kacperjurak/dtk-386-replica/images/umc_back_flip.jpg

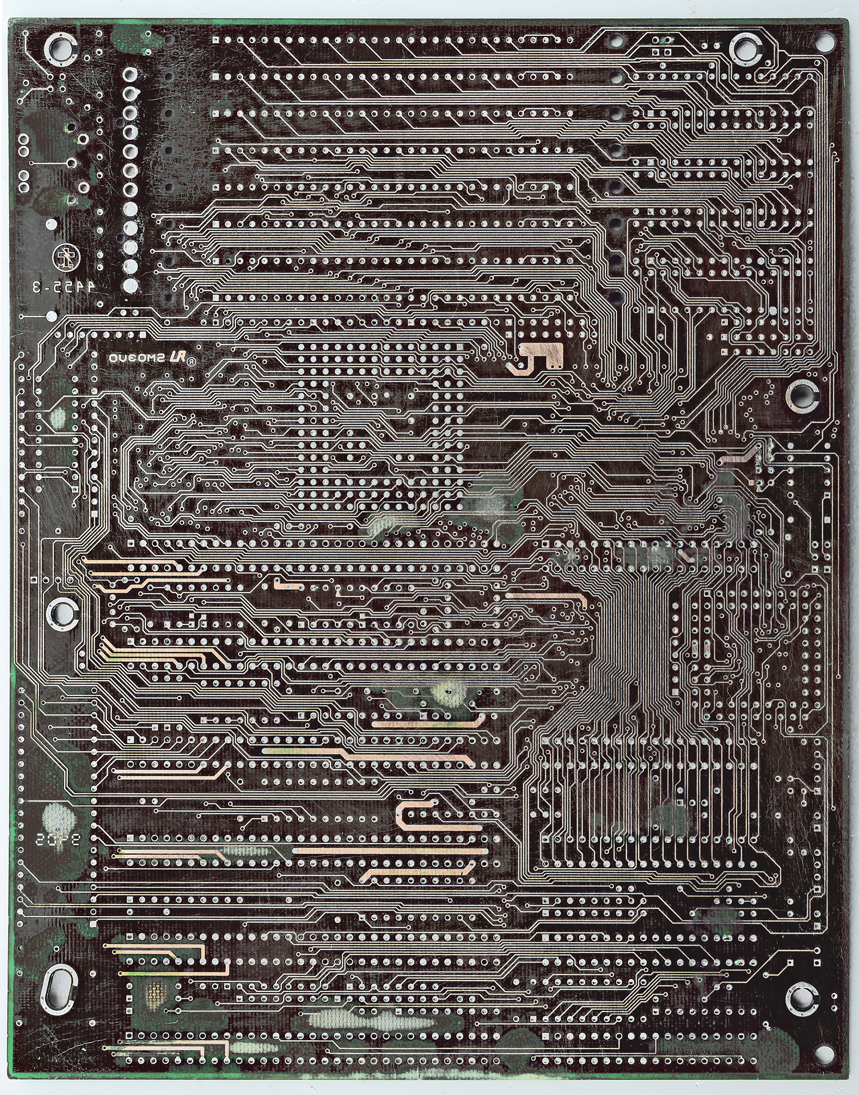
images/umc_back_flip.jpg
