kacperjurak/dtk-386-replica/images/umc_front.jpg

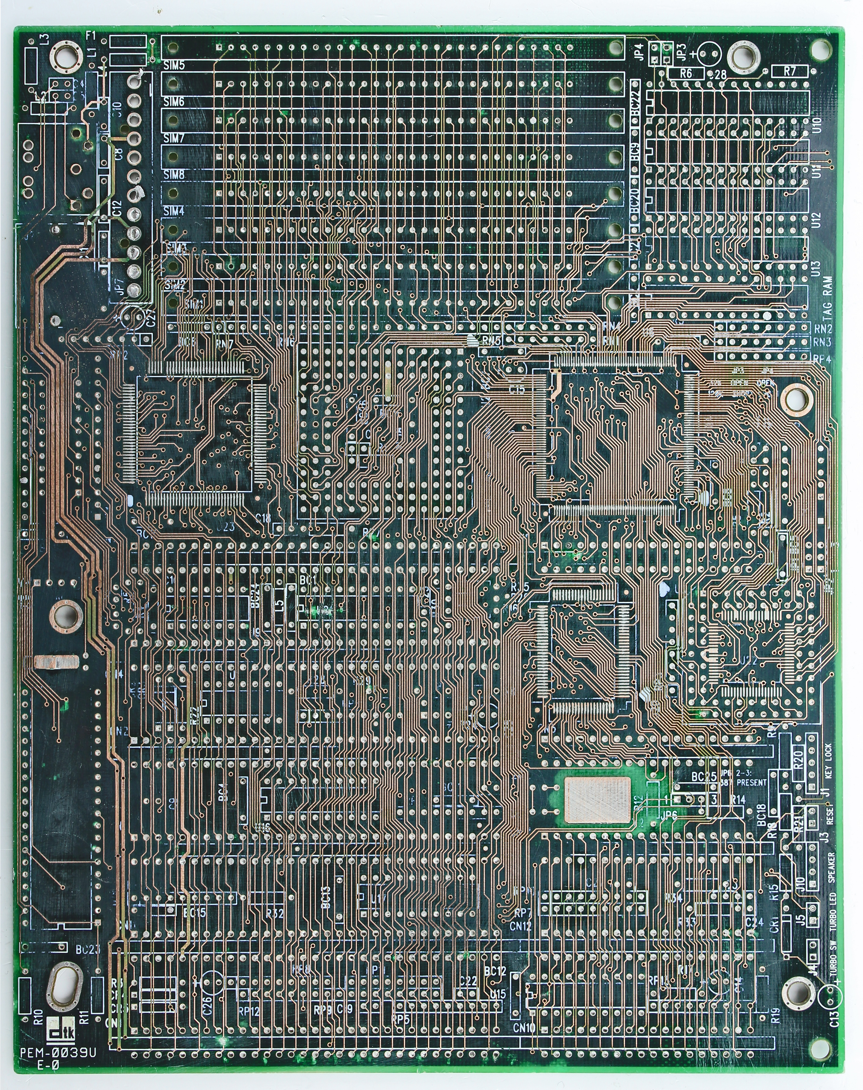
images/umc_front.jpg
