kacperjurak/dtk-386-replica/kicad/UMC-AT.kicad_pcb

## KiCad design kicad/UMC-AT.kicad_pcb (2026-10-24)

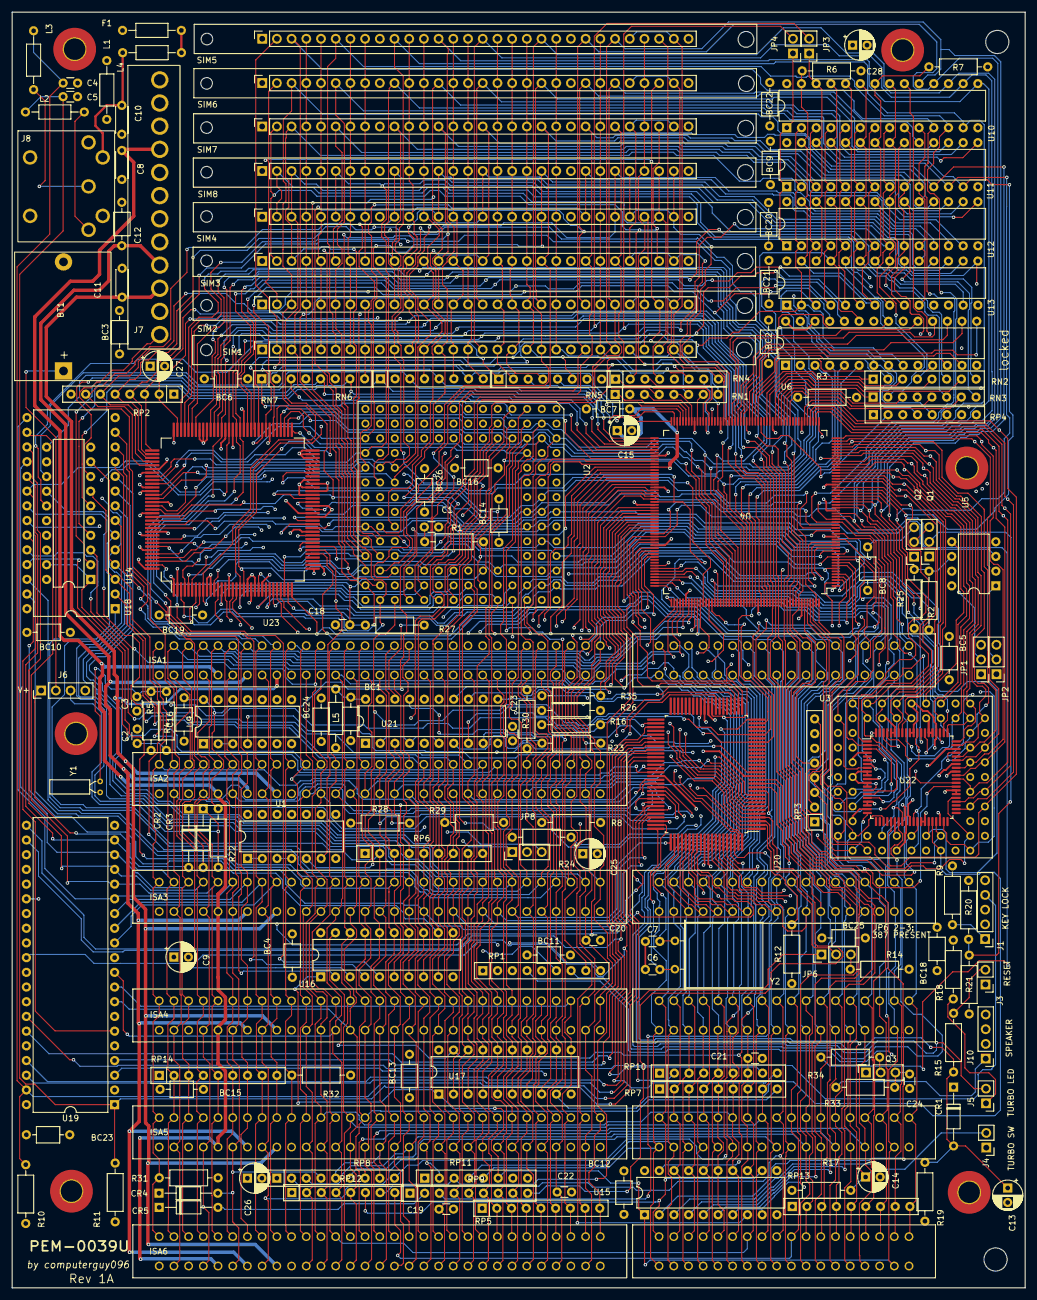
[picture p4: board UMC-AT.kicad_pcb from above]

Board: 4 copper layers, 175.0 x 220.4 mm, 179 parts (0 on the bottom side), 337 nets.

Parts:
BC1, BC2, BC3, BC4, BC5, BC6, BC7, BC8, BC9, BC10, BC11, BC12, BC13, BC14, BC15, BC16, BC18, BC19, BC20, BC21, BC22, BC23, BC24, BC25, BC26: 100nF; C_Axial_L3.8mm_D2.6mm_P7.50mm_Horizontal
BT1: 3.6V NiCd; BATT
C1, C2, C3, C4, C5, C18, C19, C20, C21, C22, C23, C24: C; C_Disc_D3.0mm_W1.6mm_P2.50mm
C6, C7: 10pF; C_Disc_D3.0mm_W1.6mm_P2.50mm
C8, C10, C11: C; C_Disc_D4.3mm_W1.9mm_P5.00mm
C9, C13, C14, C15, C25, C26, C27, C28: 10uF; CP_Radial_D5.0mm_P2.50mm
C12, C16: C; C_Axial_L3.8mm_D2.6mm_P7.50mm_Horizontal
CR1, CR2, CR3, CR4, CR5: 1N4148; D_DO-35_SOD27_P10.16mm_Horizontal
F1: 1A; L_Axial_L5.3mm_D2.2mm_P10.16mm_Horizontal_Vishay_IM-1
H1, H2, H3, H4, H5, H6: MountingHole_Pad; MountingHole_3.7mm_Pad_TopBottom
ISA1, ISA3, ISA4, ISA5, ISA6: Bus_ISA_16bit; ISA16
ISA2: Bus_ISA_8bit; ISA8
J1: KEY LOCK; PinHeader_1x05_P2.54mm_Vertical
J3: RESET; PinHeader_1x02_P2.54mm_Vertical
J4: TURBO SW; PinHeader_1x02_P2.54mm_Vertical
J5: TURBO LED; PinHeader_1x02_P2.54mm_Vertical
J6: V+; PinHeader_1x04_P2.54mm_Vertical
J7: ATPWR
J8: KB_DIN5
J10: SPEAKER; PinHeader_1x04_P2.54mm_Vertical
JP1, JP2, JP8: PinHeader_1x03_P2.54mm_Vertical
JP3, JP4: PinHeader_1x02_P2.54mm_Vertical
JP6: 387 PRESENT; PinHeader_1x03_P2.54mm_Vertical
L1, L2, L3, L4, L5: FerriteBead; L_Axial_L5.3mm_D2.2mm_P10.16mm_Horizontal_Vishay_IM-1
Q1, Q3: 2N3904; PinSocket_1x03_P2.54mm_Vertical
Q2: 2N3906; PinSocket_1x03_P2.54mm_Vertical
R1, R2, R4, R5, R6, R7, R8, R9, R10, R11, R12, R14, R15, R16, R17, R18, R19, R20, R21, R22, R23, R24, R25, R26, R28, R29, R30, R31, R32, R33, R34, R35: R; R_Axial_DIN0207_L6.3mm_D2.5mm_P10.16mm_Horizontal
R3: 10R; R_Axial_DIN0207_L6.3mm_D2.5mm_P10.16mm_Horizontal
R27: 33R; R_Axial_DIN0207_L6.3mm_D2.5mm_P10.16mm_Horizontal
RN1, RN2, RN3, RN4, RN5, RN6, RN7: 33R; R_Array_SIP8
RP1, RP5, RP6, RP7, RP8, RP9, RP10, RP13, RP14: 4.7K; R_Array_SIP9
RP2, RP3, RP4, RP11, RP12: 4.7K; R_Array_SIP8
SIM1, SIM2, SIM3, SIM4, SIM5, SIM6, SIM7, SIM8: PinSocket_1x30_P2.54mm_Vertical
U1: 74LS00; DIP-14_W7.62mm
U2: 80386; PGA-132
U3: 80387; PGA-68
U4: 82C491; QFP-208
U5: AV9107; DIP-8_W7.62mm
U6, U10, U11, U12, U13: CY62256-70PC; DIP-28_W7.62mm
U9: 4069; DIP-14_W7.62mm
U14, U21: 74LS244; DIP-20_W7.62mm
U15, U16, U17: 74LS245; DIP-20_W7.62mm
U18: 27C512; DIP-28_W15.24mm
U19: DIP-40_W15.24mm
U20: 82C493; QFP-100
U22: Cx87DLC; LQFP-80_14x14mm_P0.65mm
U23: Am386DX; QFP-132
Y1: 32.768KHz; Crystal_C26-LF_D2.1mm_L6.5mm_Horizontal
Y2: 14.318MHz; Crystal_HC49-U_Horizontal

Connections:
+12V: C11.1, ISA1.9 (+12V), ISA2.9 (+12V), ISA3.9 (+12V), ISA4.9 (+12V), ISA5.9 (+12V), ISA6.9 (+12V), J7.10 (+12V)
-5V: C8.2, ISA1.5 (-5V), ISA2.5 (-5V), ISA3.5 (-5V), ISA4.5 (-5V), ISA5.5 (-5V), ISA6.5 (-5V), J7.4 (-5V)
-12V: C12.1, ISA1.7 (-12V), ISA2.7 (-12V), ISA3.7 (-12V), ISA4.7 (-12V), ISA5.7 (-12V), ISA6.7 (-12V), J7.9 (-12V)
/CPU/PULLUP: RP1.7 (R6), U22.27 (PULLUP)
/CPU/READYO: RP3.3 (R2), U3.L3 (~READYO)
/Cache and TAG/AA10: RN2.4 (R2.2), U10.21 (A10), U11.21 (A10), U12.21 (A10), U13.21 (A10)
/Cache and TAG/AA11: RN2.6 (R3.2), U10.23 (A11), U11.23 (A11), U12.23 (A11), U13.23 (A11)
/Cache and TAG/AA13: JP3.1, RP4.5 (R4), U6.8 (A2), U10.26 (A13), U11.26 (A13), U12.26 (A13), U13.26 (A13)
/Cache and TAG/AA14: JP4.1, RP4.4 (R3), U6.7 (A3), U10.1 (A14), U11.1 (A14), U12.1 (A14), U13.1 (A14)
/Cache and TAG/CA2: RN2.3 (R2.1), U4.71 (CA2)
/Cache and TAG/CA3A: RN2.5 (R3.1), U4.70 (CA3A)
/Cache and TAG/COEA: RN2.7 (R4.1), U4.68 (~COEA)
/Cache and TAG/CS0: RN3.4 (R2.2), U10.20 (~CS)
/Cache and TAG/CS1: RN3.6 (R3.2), U11.20 (~CS)
/Cache and TAG/CS2: RN3.8 (R4.2), U12.20 (~CS)
/Cache and TAG/CS3: R3.2, U13.20 (~CS)
/Cache and TAG/CWEA: RN3.1 (R1.1), U4.67 (~CWEA)
/Cache and TAG/OE: R7.1, RN2.8 (R4.2), U10.22 (~OE), U11.22 (~OE), U12.22 (~OE), U13.22 (~OE)
/Cache and TAG/TAG0: U4.83 (TAG0), U6.19 (Q7)
/Cache and TAG/TAG1: U4.82 (TAG1), U6.18 (Q6)
/Cache and TAG/TAG2: U4.81 (TAG2), U6.17 (Q5)
/Cache and TAG/TAG3: U4.80 (TAG3), U6.16 (Q4)
/Cache and TAG/TAG4: U4.79 (TAG4), U6.15 (Q3)
/Cache and TAG/TAG5: U4.77 (TAG5), U6.13 (Q2)
/Cache and TAG/TAG6: U4.76 (TAG6), U6.12 (Q1)
/Cache and TAG/TAG7: U4.75 (TAG7), U6.11 (Q0)
/Cache and TAG/TAGWE: RN2.1 (R1.1), U4.74 (~TAGWE)
/Cache and TAG/TWE: RN2.2 (R1.2), U6.27 (~WE)
/Cache and TAG/WE: R6.1, RN3.2 (R1.2), U10.27 (~WE), U11.27 (~WE), U12.27 (~WE), U13.27 (~WE)
/Chipset/BUFCLK: R28.2, U21.3 (O3b)
/Chipset/CHPCLK: R26.2, U4.141 (ATCLK)
/Chipset/DAC0: U4.116 (DAC0), U20.5 (DAC0)
/Chipset/DAC1: U4.114 (DAC1), U20.6 (DAC1)
/Chipset/DAC2: U4.113 (DAC2), U20.7 (DAC2)
/Chipset/FPUEN: JP6.2, U4.118 (SEL1), U20.3 (SEL1)
/Chipset/JP8/3: JP8.3, U21.16 (O1a)
/Chipset/LOWEN: R35.2, U4.130 (~LOWEN), U20.33 (~LOWEN)
/Chipset/MUXI0: U4.123 (MUXI0), U20.99 (MUXI0)
/Chipset/MUXI1: U4.121 (MUXI1), U20.100 (MUXI1)
/Chipset/MUXI2: U4.120 (MUXI2), U20.1 (MUXI2)
/Chipset/PALE: U4.143 (ALE), U21.11 (I0b)
/Chipset/POWGD: U4.129 (POWGD), U20.34 (POWGD)
/Chipset/RSTIN: U4.171 (~RSTIN), U20.29 (~RSTIN)
/Chipset/SYSCLK: C23.1, R30.1, U20.16 (SYSCLK)
/Chipset/XTL1: C6.2, U20.80 (XTL2), Y2.1
/Chipset/XTL2: C7.2, U20.79 (XTL1), Y2.2
/DRAM/A11: RN4.8 (R4.2), SIM1.24 (A11), SIM2.24 (A11), SIM3.24 (A11), SIM4.24 (A11), SIM5.24 (A11), SIM6.24 (A11), SIM7.24 (A11), SIM8.24 (A11)
/DRAM/CAS0: RN1.4 (R2.2), SIM1.2 (~CAS), SIM1.28 (~CASP), SIM5.2 (~CAS), SIM5.28 (~CASP)
/DRAM/CAS1: RN1.8 (R4.2), SIM2.2 (~CAS), SIM2.28 (~CASP), SIM6.2 (~CAS), SIM6.28 (~CASP)
/DRAM/CAS2: RN4.2 (R1.2), SIM3.2 (~CAS), SIM3.28 (~CASP), SIM7.2 (~CAS), SIM7.28 (~CASP)
/DRAM/CAS3: RN4.4 (R2.2), SIM4.2 (~CAS), SIM4.28 (~CASP), SIM8.2 (~CAS), SIM8.28 (~CASP)
/DRAM/MA0: RN7.2 (R1.2), SIM1.4 (A0), SIM2.4 (A0), SIM3.4 (A0), SIM4.4 (A0), SIM5.4 (A0), SIM6.4 (A0), SIM7.4 (A0), SIM8.4 (A0)
/DRAM/MA1: RN7.4 (R2.2), SIM1.5 (A1), SIM2.5 (A1), SIM3.5 (A1), SIM4.5 (A1), SIM5.5 (A1), SIM6.5 (A1), SIM7.5 (A1), SIM8.5 (A1)
/DRAM/MA2: RN7.6 (R3.2), SIM1.7 (A2), SIM2.7 (A2), SIM3.7 (A2), SIM4.7 (A2), SIM5.7 (A2), SIM6.7 (A2), SIM7.7 (A2), SIM8.7 (A2)
/DRAM/MA3: RN7.8 (R4.2), SIM1.8 (A3), SIM2.8 (A3), SIM3.8 (A3), SIM4.8 (A3), SIM5.8 (A3), SIM6.8 (A3), SIM7.8 (A3), SIM8.8 (A3)
/DRAM/MA4: RN6.2 (R1.2), SIM1.11 (A4), SIM2.11 (A4), SIM3.11 (A4), SIM4.11 (A4), SIM5.11 (A4), SIM6.11 (A4), SIM7.11 (A4), SIM8.11 (A4)
/DRAM/MA5: RN6.4 (R2.2), SIM1.12 (A5), SIM2.12 (A5), SIM3.12 (A5), SIM4.12 (A5), SIM5.12 (A5), SIM6.12 (A5), SIM7.12 (A5), SIM8.12 (A5)
/DRAM/MA6: RN6.6 (R3.2), SIM1.14 (A6), SIM2.14 (A6), SIM3.14 (A6), SIM4.14 (A6), SIM5.14 (A6), SIM6.14 (A6), SIM7.14 (A6), SIM8.14 (A6)
/DRAM/MA7: RN6.8 (R4.2), SIM1.15 (A7), SIM2.15 (A7), SIM3.15 (A7), SIM4.15 (A7), SIM5.15 (A7), SIM6.15 (A7), SIM7.15 (A7), SIM8.15 (A7)
/DRAM/MA8: RN5.2 (R1.2), SIM1.17 (A8), SIM2.17 (A8), SIM3.17 (A8), SIM4.17 (A8), SIM5.17 (A8), SIM6.17 (A8), SIM7.17 (A8), SIM8.17 (A8)
/DRAM/MA9: RN5.4 (R2.2), SIM1.18 (A9), SIM2.18 (A9), SIM3.18 (A9), SIM4.18 (A9), SIM5.18 (A9), SIM6.18 (A9), SIM7.18 (A9), SIM8.18 (A9)
/DRAM/MA10: RN5.6 (R3.2), SIM1.19 (A10), SIM2.19 (A10), SIM3.19 (A10), SIM4.19 (A10), SIM5.19 (A10), SIM6.19 (A10), SIM7.19 (A10), SIM8.19 (A10)
/DRAM/PA2: RN7.5 (R3.1), U4.109 (MA2), U14.2 (I0a)
/DRAM/PA3: RN7.7 (R4.1), U4.108 (MA3), U14.4 (I1a)
/DRAM/PA4: RN6.1 (R1.1), U4.107 (MA4), U14.6 (I2a)
/DRAM/PA5: RN6.3 (R2.1), U4.106 (MA5), U14.8 (I3a)
/DRAM/PA6: RN6.5 (R3.1), U4.105 (MA6), U14.11 (I0b)
/DRAM/PA7: RN6.7 (R4.1), U4.104 (MA7), U14.13 (I1b)
/DRAM/PA8: RN5.1 (R1.1), U4.103 (MA8), U14.15 (I2b)
/DRAM/PAR0: SIM1.26 (PO), SIM1.29 (PI), SIM5.26 (PO), SIM5.29 (PI), U4.88 (PAR0)
/DRAM/PAR1: SIM2.26 (PO), SIM2.29 (PI), SIM6.26 (PO), SIM6.29 (PI), U4.86 (PAR1)
/DRAM/PAR2: SIM3.26 (PO), SIM3.29 (PI), SIM7.26 (PO), SIM7.29 (PI), U4.85 (PAR2)
/DRAM/PAR3: SIM4.26 (PO), SIM4.29 (PI), SIM8.26 (PO), SIM8.29 (PI), U4.84 (PAR3)
/DRAM/RAS0: RN1.2 (R1.2), SIM1.27 (~RAS), SIM2.27 (~RAS), SIM3.27 (~RAS), SIM4.27 (~RAS)
/DRAM/RAS1: RN1.6 (R3.2), SIM5.27 (~RAS), SIM6.27 (~RAS), SIM7.27 (~RAS), SIM8.27 (~RAS)
/DRAM/WE: RN4.6 (R3.2), SIM1.21 (~WE), SIM2.21 (~WE), SIM3.21 (~WE), SIM4.21 (~WE), SIM5.21 (~WE), SIM6.21 (~WE), SIM7.21 (~WE), SIM8.21 (~WE)
/KBGND: C10.1, H1.1, J8.2 (GND), L4.1
/VBATT: BT1.1 (+), J6.2
A2: U2.C4 (A2), U3.L8 (~CMD0), U4.175 (A2), U17.9 (A7), U22.36 (~CMD0), U23.67 (A2)
A3: U2.A3, U4.176 (A3), U17.8 (A6), U23.68 (A3)
A4: U2.B3 (A4), U4.177 (A4), U6.21 (A10), U10.24 (A9), U11.24 (A9), U12.24 (A9), U13.24 (A9), U17.7 (A5), U23.69 (A4)
A5: U2.B2 (A5), U4.178 (A5), U6.23 (A11), U10.25 (A8), U11.25 (A8), U12.25 (A8), U13.25 (A8), U17.6 (A4), U23.70 (A5)
A6: U2.C3 (A6), U4.179 (A6), U6.24 (A9), U10.9 (A1), U11.9 (A1), U12.9 (A1), U13.9 (A1), U17.5 (A3), U23.71 (A6)
A7: U2.C2 (A7), U4.180 (A7), U6.25 (A8), U10.10 (A0), U11.10 (A0), U12.10 (A0), U13.10 (A0), U17.4 (A2), U23.72 (A7)
A8: U2.C1 (A8), U4.181 (A8), U6.9 (A1), U10.2 (A12), U11.2 (A12), U12.2 (A12), U13.2 (A12), U17.3 (A1), U23.74 (A8)
A9: U2.D3 (A9), U4.182 (A9), U6.10 (A0), U10.3 (A7), U11.3 (A7), U12.3 (A7), U13.3 (A7), U17.2 (A0), U23.75 (A9)
A10: U2.D2 (A10), U4.183 (A10), U6.2 (A12), U10.4 (A6), U11.4 (A6), U12.4 (A6), U13.4 (A6), U16.9 (A7), U23.76 (A10)
A11: U2.D1 (A11), U4.184 (A11), U6.3 (A7), U10.5 (A5), U11.5 (A5), U12.5 (A5), U13.5 (A5), U16.8 (A6), U23.77 (A11)
A12: U2.E3 (A12), U4.185 (A12), U6.4 (A6), U10.6 (A4), U11.6 (A4), U12.6 (A4), U13.6 (A4), U16.7 (A5), U23.78 (A12)
A13: U2.E2 (A13), U4.186 (A13), U6.5 (A5), U10.7 (A3), U11.7 (A3), U12.7 (A3), U13.7 (A3), U16.6 (A4), U23.79 (A13)
A14: U2.E1 (A14), U4.188 (A14), U6.6 (A4), U10.8 (A2), U11.8 (A2), U12.8 (A2), U13.8 (A2), U16.5 (A3), U23.81 (A14)
A15: JP4.2, U2.F1 (A15), U4.189 (A15), U16.4 (A2), U23.82 (A15)
A16: JP3.2, U2.G1 (A16), U4.190 (A16), U16.3 (A1), U23.84 (A16)
A17: U2.H1 (A17), U4.191 (A17), U16.2 (A0), U23.86 (A17)
A18: U2.H2 (A18), U4.192 (A18), U15.7 (A5), U23.87 (A18)
A19: U2.H3 (A19), U4.193 (A19), U15.6 (A4), U23.88 (A19)
A20: U2.J1 (A20), U4.194 (A20), U15.5 (A3), U23.89 (A20)
A20M: U2.F13 (~A20M), U4.1 (~A20M), U23.60 (~A20M)
A21: U2.K1 (A21), U4.196 (A21), U15.4 (A2), U23.93 (A21)
A22: U2.K2 (A22), U4.197 (A22), U15.3 (A1), U23.94 (A22)
A23: U2.L1 (A23), U4.198 (A23), U15.2 (A0), U23.95 (A23)
A24: U2.L2 (A24), U4.199 (A24), U23.96 (A24)
A25: U2.K3 (A25), U4.200 (A25), U23.97 (A25)
A26: RP2.2 (R1), U2.M1 (A26), U23.98 (A26)
A27: RP2.3 (R2), U2.N1 (A27), U23.100 (A27)
A28: RP2.4 (R3), U2.L3 (A28), U23.101 (A28)
A29: RP2.5 (R4), U2.M2 (A29), U23.102 (A29)
A30: RP2.6 (R5), U2.P1 (A30), U23.103 (A30)
A31: RP2.7 (R6), U2.N2 (A31), U3.K6 (NPS2), U4.201 (A31), U22.32 (NPS2), U23.104 (A31)
ADS: RP1.6 (R5), U2.E14 (~ADS), U3.K7 (~ADS), U4.7 (~ADS), U22.35 (~ADS), U23.27 (~ADS)
AEN: ISA1.42 (AEN), ISA2.42 (AEN), ISA3.42 (AEN), ISA4.42 (AEN), ISA5.42 (AEN), ISA6.42 (AEN), U20.65 (AEN)
ALE: C22.2, ISA1.28 (ALE), ISA2.28 (ALE), ISA3.28 (ALE), ISA4.28 (ALE), ISA5.28 (ALE), ISA6.28 (ALE), U21.9 (O0b)
ATCLK: C19.2, ISA1.20 (CLK), ISA2.20 (CLK), ISA3.20 (CLK), ISA4.20 (CLK), ISA5.20 (CLK), ISA6.20 (CLK), R29.1
BA0: ISA1.62 (BA00), ISA2.62 (BA00), ISA3.62 (BA00), ISA4.62 (BA00), ISA5.62 (BA00), ISA6.62 (BA00), RP5.9 (R8), U4.146 (A0), U18.10 (A0)
BA1: ISA1.61 (BA01), ISA2.61 (BA01), ISA3.61 (BA01), ISA4.61 (BA01), ISA5.61 (BA01), ISA6.61 (BA01), RP5.8 (R7), U4.145 (A1), U18.9 (A1)
BA2: ISA1.60 (BA02), ISA2.60 (BA02), ISA3.60 (BA02), ISA4.60 (BA02), ISA5.60 (BA02), ISA6.60 (BA02), RP5.7 (R6), U14.18 (O0a), U17.11 (B7), U18.8 (A2), U19.9 (A2)
BA3: ISA1.59 (BA03), ISA2.59 (BA03), ISA3.59 (BA03), ISA4.59 (BA03), ISA5.59 (BA03), ISA6.59 (BA03), RP5.6 (R5), U14.16 (O1a), U17.12 (B6), U18.7 (A3)
BA4: ISA1.58 (BA04), ISA2.58 (BA04), ISA3.58 (BA04), ISA4.58 (BA04), ISA5.58 (BA04), ISA6.58 (BA04), RP5.5 (R4), U14.14 (O2a), U17.13 (B5), U18.6 (A4)
BA5: ISA1.57 (BA05), ISA2.57 (BA05), ISA3.57 (BA05), ISA4.57 (BA05), ISA5.57 (BA05), ISA6.57 (BA05), RP5.4 (R3), U14.12 (O3a), U17.14 (B4), U18.5 (A5)
BA6: ISA1.56 (BA06), ISA2.56 (BA06), ISA3.56 (BA06), ISA4.56 (BA06), ISA5.56 (BA06), ISA6.56 (BA06), RP5.3 (R2), U14.9 (O0b), U17.15 (B3), U18.4 (A6)
BA7: ISA1.55 (BA07), ISA2.55 (BA07), ISA3.55 (BA07), ISA4.55 (BA07), ISA5.55 (BA07), ISA6.55 (BA07), RP5.2 (R1), U14.7 (O1b), U17.16 (B2), U18.3 (A7)
BA8: ISA1.54 (BA08), ISA2.54 (BA08), ISA3.54 (BA08), ISA4.54 (BA08), ISA5.54 (BA08), ISA6.54 (BA08), RP6.9 (R8), U14.5 (O2b), U17.17 (B1), U18.25 (A8)
BA9: ISA1.53 (BA09), ISA2.53 (BA09), ISA3.53 (BA09), ISA4.53 (BA09), ISA5.53 (BA09), ISA6.53 (BA09), RP6.8 (R7), U17.18 (B0), U18.24 (A9)
BA10: ISA1.52 (BA10), ISA2.52 (BA10), ISA3.52 (BA10), ISA4.52 (BA10), ISA5.52 (BA10), ISA6.52 (BA10), RP6.7 (R6), U16.11 (B7), U18.21 (A10)
BA11: ISA1.51 (BA11), ISA2.51 (BA11), ISA3.51 (BA11), ISA4.51 (BA11), ISA5.51 (BA11), ISA6.51 (BA11), RP6.6 (R5), U16.12 (B6), U18.23 (A11)
BA12: ISA1.50 (BA12), ISA2.50 (BA12), ISA3.50 (BA12), ISA4.50 (BA12), ISA5.50 (BA12), ISA6.50 (BA12), RP6.5 (R4), U16.13 (B5), U18.2 (A12)
BA13: ISA1.49 (BA13), ISA2.49 (BA13), ISA3.49 (BA13), ISA4.49 (BA13), ISA5.49 (BA13), ISA6.49 (BA13), RP6.4 (R3), U16.14 (B4), U18.26 (A13)
BA14: ISA1.48 (BA14), ISA2.48 (BA14), ISA3.48 (BA14), ISA4.48 (BA14), ISA5.48 (BA14), ISA6.48 (BA14), RP6.3 (R2), U16.15 (B3), U18.27 (A14)
BA15: ISA1.47 (BA15), ISA2.47 (BA15), ISA3.47 (BA15), ISA4.47 (BA15), ISA5.47 (BA15), ISA6.47 (BA15), RP6.2 (R1), U16.16 (B2), U18.1 (A15)
BA16: ISA1.46 (BA16), ISA2.46 (BA16), ISA3.46 (BA16), ISA4.46 (BA16), ISA5.46 (BA16), ISA6.46 (BA16), RP7.9 (R8), U16.17 (B1)
BA17: ISA1.45 (BA17), ISA1.88 (LA17), ISA2.45 (BA17), ISA3.45 (BA17), ISA3.88 (LA17), ISA4.45 (BA17), ISA4.88 (LA17), ISA5.45 (BA17), ISA5.88 (LA17), ISA6.45 (BA17), ISA6.88 (LA17), RP7.8 (R7), U16.18 (B0)
BA18: ISA1.44 (BA18), ISA1.87 (LA18), ISA2.44 (BA18), ISA3.44 (BA18), ISA3.87 (LA18), ISA4.44 (BA18), ISA4.87 (LA18), ISA5.44 (BA18), ISA5.87 (LA18), ISA6.44 (BA18), ISA6.87 (LA18), RP7.7 (R6), U15.13 (B5)
BA19: ISA1.43 (BA19), ISA1.86 (LA19), ISA2.43 (BA19), ISA3.43 (BA19), ISA3.86 (LA19), ISA4.43 (BA19), ISA4.86 (LA19), ISA5.43 (BA19), ISA5.86 (LA19), ISA6.43 (BA19), ISA6.86 (LA19), RP7.6 (R5), U14.3 (O3b), U15.14 (B4)
BA20: ISA1.85 (LA20), ISA3.85 (LA20), ISA4.85 (LA20), ISA5.85 (LA20), ISA6.85 (LA20), RP7.5 (R4), U15.15 (B3)
BA21: ISA1.84 (LA21), ISA3.84 (LA21), ISA4.84 (LA21), ISA5.84 (LA21), ISA6.84 (LA21), RP7.4 (R3), U15.16 (B2)
BA22: ISA1.83 (LA22), ISA3.83 (LA22), ISA4.83 (LA22), ISA5.83 (LA22), ISA6.83 (LA22), RP7.3 (R2), U15.17 (B1)
BA23: ISA1.82 (LA23), ISA3.82 (LA23), ISA4.82 (LA23), ISA5.82 (LA23), ISA6.82 (LA23), RP7.2 (R1), U15.18 (B0)
BE0: U2.E12 (~BE0), U4.13 (~BE0), U23.31 (~BE0)
BE1: U2.C13 (~BE1), U4.14 (~BE1), U23.32 (~BE1)
BE2: U2.B13 (~BE2), U4.15 (~BE2), U23.33 (~BE2)
BE3: U2.A13 (~BE3), U4.16 (~BE3), U23.38 (~BE3)
BHE: U4.144 (~BHE), U15.8 (A6)
BLAST: RP3.2 (R1), U4.204 (~BLAST)
BS16: RP1.9 (R8), U2.C14 (~BS16), U23.29 (~BS16)
BUSY: U2.B9 (~BUSY), U4.3 (~PEADS), U23.46 (~BUSY)
CLK: R2.2, R25.2, U5.6 (CLK)
CLK2: C18.2, R1.1, R27.1, U2.F12 (CLK2), U23.24 (CLK2)
CLKRTC: U4.170 (XTL1), U9.4
D0: SIM1.3 (D0), SIM5.3 (D0), U2.H12 (D0), U3.H2 (D0), U4.23 (PD0), U10.11 (Q0), U22.2 (D0), U23.20 (D0)
D1: SIM1.6 (D1), SIM5.6 (D1), U2.H13 (D1), U3.H1 (D1), U4.24 (PD1), U10.12 (Q1), U22.3 (D1), U23.19 (D1)
D2: SIM1.10 (D2), SIM5.10 (D2), U2.H14 (D2), U3.G2 (D2), U4.25 (PD2), U10.13 (Q2), U22.7 (D2), U23.18 (D2)
D3: SIM1.13 (D3), SIM5.13 (D3), U2.J14 (D3), U3.G1 (D3), U4.26 (PD3), U10.15 (Q3), U22.69 (D3), U23.17 (D3)
D4: SIM1.16 (D4), SIM5.16 (D4), U2.K14 (D4), U3.D2 (D4), U4.28 (PD4), U10.16 (Q4), U22.68 (D4), U23.15 (D4)
D5: SIM1.20 (D5), SIM5.20 (D5), U2.K13 (D5), U3.D1 (D5), U4.29 (PD5), U10.17 (Q5), U22.67 (D5), U23.14 (D5)
D6: SIM1.23 (D6), SIM5.23 (D6), U2.L14 (D6), U3.C2 (D6), U4.30 (PD6), U10.18 (Q6), U22.63 (D6), U23.13 (D6)
D7: SIM1.25 (D7), SIM5.25 (D7), U2.K12 (D7), U3.C1 (D7), U4.31 (PD7), U10.19 (Q7), U22.62 (D7), U23.12 (D7)
D8: SIM2.3 (D0), SIM6.3 (D0), U2.L13 (D8), U3.B1 (D8), U4.32 (PD8), U11.11 (Q0), U22.8 (D8), U23.9 (D8)
D9: SIM2.6 (D1), SIM6.6 (D1), U2.N14 (D9), U3.A2 (D9), U4.33 (PD9), U11.12 (Q1), U22.14 (D9), U23.7 (D9)
D10: SIM2.10 (D2), SIM6.10 (D2), U2.M12 (D10), U3.B3 (D10), U4.34 (PD10), U11.13 (Q2), U22.15 (D10), U23.6 (D10)
D11: SIM2.13 (D3), SIM6.13 (D3), U2.N13 (D11), U3.A3 (D11), U4.35 (PD11), U11.15 (Q3), U22.16 (D11), U23.5 (D11)
D12: SIM2.16 (D4), SIM6.16 (D4), U2.N12 (D12), U3.A4 (D12), U4.37 (PD12), U11.16 (Q4), U22.79 (D12), U23.4 (D12)
D13: SIM2.20 (D5), SIM6.20 (D5), U2.P13 (D13), U3.B5 (D13), U4.38 (PD13), U11.17 (Q5), U22.78 (D13), U23.3 (D13)
D14: SIM2.23 (D6), SIM6.23 (D6), U2.P12 (D14), U3.A5 (D14), U4.39 (PD14), U11.18 (Q6), U22.74 (D14), U23.131 (D14)
D15: SIM2.25 (D7), SIM6.25 (D7), U2.M11 (D15), U3.B6 (D15), U4.40 (PD15), U11.19 (Q7), U22.73 (D15), U23.130 (D15)
D16: SIM3.3 (D0), SIM7.3 (D0), U2.N11 (D16), U3.A7 (D16), U4.41 (PD16), U12.11 (Q0), U22.1 (D16), U23.129 (D16)
D17: SIM3.6 (D1), SIM7.6 (D1), U2.N10 (D17), U3.B8 (D17), U4.42 (PD17), U12.12 (Q1), U22.72 (D17), U23.128 (D17)
D18: SIM3.10 (D2), SIM7.10 (D2), U2.P11 (D18), U3.A8 (D18), U4.43 (PD18), U12.13 (Q2), U22.80 (D18), U23.126 (D18)
D19: SIM3.13 (D3), SIM7.13 (D3), U2.P10 (D19), U3.B9 (D19), U4.44 (PD19), U12.15 (Q3), U22.77 (D19), U23.125 (D19)
D20: SIM3.16 (D4), SIM7.16 (D4), U2.M9 (D20), U3.B10 (D20), U4.46 (PD20), U12.16 (Q4), U22.61 (D20), U23.124 (D20)
D21: SIM3.20 (D5), SIM7.20 (D5), U2.N9 (D21), U3.A10 (D21), U4.47 (PD21), U12.17 (Q5), U22.60 (D21), U23.121 (D21)
D22: SIM3.23 (D6), SIM7.23 (D6), U2.P9 (D22), U3.B11 (D22), U4.48 (PD22), U12.18 (Q6), U22.59 (D22), U23.120 (D22)
D23: SIM3.25 (D7), SIM7.25 (D7), U2.N8 (D23), U3.C10 (D23), U4.49 (PD23), U12.19 (Q7), U22.57 (D23), U23.119 (D23)
D24: SIM4.3 (D0), SIM8.3 (D0), U2.P7 (D24), U3.D10 (D24), U4.50 (PD24), U13.11 (Q0), U22.56 (D24), U23.118 (D24)
D25: SIM4.6 (D1), SIM8.6 (D1), U2.N6 (D25), U3.D11 (D25), U4.51 (PD25), U13.12 (Q1), U22.55 (D25), U23.116 (D25)
D26: SIM4.10 (D2), SIM8.10 (D2), U2.P5 (D26), U3.E10 (D26), U4.52 (PD26), U13.13 (Q2), U22.53 (D26), U23.115 (D26)
D27: SIM4.13 (D3), SIM8.13 (D3), U2.N5 (D27), U3.E11 (D27), U4.54 (PD27), U13.15 (Q3), U22.51 (D27), U23.113 (D27)
D28: SIM4.16 (D4), SIM8.16 (D4), U2.M6 (D28), U3.G10 (D28), U4.55 (PD28), U13.16 (Q4), U22.50 (D28), U23.112 (D28)
D29: SIM4.20 (D5), SIM8.20 (D5), U2.P4 (D29), U3.G11 (D29), U4.56 (PD29), U13.17 (Q5), U22.44 (D29), U23.109 (D29)
D30: SIM4.23 (D6), SIM8.23 (D6), U2.P3 (D30), U3.H10 (D30), U4.57 (PD30), U13.18 (Q6), U22.42 (D30), U23.108 (D30)
D31: SIM4.25 (D7), SIM8.25 (D7), U2.M5 (D31), U3.H11 (D31), U4.58 (PD31), U13.19 (Q7), U22.25 (D31), U23.107 (D31)
DACK0: ISA1.70 (~DACK0), ISA3.70 (~DACK0), ISA4.70 (~DACK0), ISA5.70 (~DACK0), ISA6.70 (~DACK0), U20.11 (~DACK0)
DACK1: ISA1.17 (~DACK1), ISA2.17 (~DACK1), ISA3.17 (~DACK1), ISA4.17 (~DACK1), ISA5.17 (~DACK1), ISA6.17 (~DACK1), U20.9 (~DACK1)
DACK2: ISA1.26 (~DACK2), ISA2.26 (~DACK2), ISA3.26 (~DACK2), ISA4.26 (~DACK2), ISA5.26 (~DACK2), ISA6.26 (~DACK2), U20.10 (~DACK2)
DACK3: ISA1.15 (~DACK3), ISA2.15 (~DACK3), ISA3.15 (~DACK3), ISA4.15 (~DACK3), ISA5.15 (~DACK3), ISA6.15 (~DACK3), U20.8 (~DACK3)
DACK5: ISA1.72 (~DACK5), ISA3.72 (~DACK5), ISA4.72 (~DACK5), ISA5.72 (~DACK5), ISA6.72 (~DACK5), U20.12 (~DACK5)
DACK6: ISA1.74 (~DACK6), ISA3.74 (~DACK6), ISA4.74 (~DACK6), ISA5.74 (~DACK6), ISA6.74 (~DACK6), U20.13 (~DACK6)
DACK7: ISA1.76 (~DACK7), ISA3.76 (~DACK7), ISA4.76 (~DACK7), ISA5.76 (~DACK7), ISA6.76 (~DACK7), U20.14 (~DACK7)
DRQ0: ISA1.71 (DRQ0), ISA3.71 (DRQ0), ISA4.71 (DRQ0), ISA5.71 (DRQ0), ISA6.71 (DRQ0), RP8.2 (R1), U20.89 (DRQ0)
DRQ1: ISA1.18 (DRQ1), ISA2.18 (DRQ1), ISA3.18 (DRQ1), ISA4.18 (DRQ1), ISA5.18 (DRQ1), ISA6.18 (DRQ1), RP8.3 (R2), U20.72 (DRQ1)
DRQ2: CR4.2 (A), ISA1.6 (DRQ2), ISA2.6 (DRQ2), ISA3.6 (DRQ2), ISA4.6 (DRQ2), ISA5.6 (DRQ2), ISA6.6 (DRQ2), RP8.4 (R3), U20.68 (DRQ2)
DRQ3: ISA1.16 (DRQ3), ISA2.16 (DRQ3), ISA3.16 (DRQ3), ISA4.16 (DRQ3), ISA5.16 (DRQ3), ISA6.16 (DRQ3), RP8.5 (R4), U20.71 (DRQ3)
DRQ5: ISA1.73 (DRQ5), ISA3.73 (DRQ5), ISA4.73 (DRQ5), ISA5.73 (DRQ5), ISA6.73 (DRQ5), RP8.6 (R5), U20.92 (DRQ5)
DRQ6: ISA1.75 (DRQ6), ISA3.75 (DRQ6), ISA4.75 (DRQ6), ISA5.75 (DRQ6), ISA6.75 (DRQ6), RP8.7 (R6), U20.93 (DRQ6)
DRQ7: ISA1.77 (DRQ7), ISA3.77 (DRQ7), ISA4.77 (DRQ7), ISA5.77 (DRQ7), ISA6.77 (DRQ7), RP8.8 (R7), U20.94 (DRQ7)
D/C: U2.A11 (D/~C), U4.12 (D/~C), U23.41 (D/~C)
ELBA: RP3.6 (R5), U4.8 (~ELBA)
FERR: RP3.8 (R7), U3.L2 (~ERROR), U4.2 (~FERR), U22.20 (~ERROR)
FERROR: RP3.7 (R6), U2.A8 (~ERROR), U4.4 (~IGNNE), U23.47 (~ERROR)
FLUSH: U1.6, U2.E13 (~FLUSH), U23.39 (~FLUSH)
GND: BC1.1, BC2.2, BC3.2, BC4.2, BC5.2, BC6.2, BC7.1, BC8.1, BC9.2, BC10.2, BC11.2, BC12.2, BC13.2, BC14.2, BC15.2, BC16.2, BC18.2, BC19.2, BC20.2, BC21.2, BC22.2, BC23.2, BC24.2, BC25.2, BC26.2, BT1.2 (-), C1.2, C2.2, C3.1, C4.2, C5.2, C6.1, C7.1, C8.1, C9.2, C11.2, C12.2, C13.2, C14.2, C15.2, C16.1, C18.1, C19.1, C20.2, C21.1, C22.1, C23.2, C24.1, C25.2, C26.2, C27.2, C28.2, CR4.1 (K), CR5.1 (K), H2.1, H3.1, H4.1, H5.1, H6.1, ISA1.1 (GND), ISA1.10 (GND), ISA1.31 (GND), ISA1.80 (GND), ISA2.1 (GND), ISA2.10 (GND), ISA2.31 (GND), ISA3.1 (GND), ISA3.10 (GND), ISA3.31 (GND), ISA3.80 (GND), ISA4.1 (GND), ISA4.10 (GND), ISA4.31 (GND), ISA4.80 (GND), ISA5.1 (GND), ISA5.10 (GND), ISA5.31 (GND), ISA5.80 (GND), ISA6.1 (GND), ISA6.10 (GND), ISA6.31 (GND), ISA6.80 (GND), J1.2, J1.3, J1.5, J3.1, J4.1, J6.4, J7.5 (GND), J7.6 (GND), J7.7 (GND), J7.8 (GND), J10.3, JP1.3, JP2.3, L4.2, Q1.1 (E), Q3.1 (E), R6.2, R7.2, R10.1, R11.1, R14.2, R20.2, R35.1, RP2.1 (common), RP8.1 (common), SIM1.9 (GND), SIM1.22 (GND), SIM2.9 (GND), SIM2.22 (GND), SIM3.9 (GND), SIM3.22 (GND), SIM4.9 (GND), SIM4.22 (GND), SIM5.9 (GND), SIM5.22 (GND), SIM6.9 (GND), SIM6.22 (GND), SIM7.9 (GND), SIM7.22 (GND), SIM8.9 (GND), SIM8.22 (GND), U1.7 (GND), U2.A2 (VSS), U2.A6 (VSS), U2.A9 (VSS), U2.B1 (VSS), U2.B5 (VSS), U2.B11 (VSS), U2.B14 (VSS), U2.C11 (VSS), U2.F2 (VSS), U2.F3 (VSS), U2.F14 (VSS), U2.J2 (VSS), U2.J3 (VSS), U2.J12 (VSS), U2.J13 (VSS), U2.M4 (VSS), U2.M8 (VSS), U2.M10 (VSS), U2.N3 (VSS), U2.P6 (VSS), U2.P14 (VSS), U3.B2 (VSS), U3.B7 (VSS), U3.C11 (VSS), U3.E2 (VSS), U3.F2 (VSS), U3.F11 (VSS), U3.J1 (VSS), U3.J10 (VSS), U3.L5 (VSS), U4.18 (GND), U4.27 (GND), U4.36 (GND), U4.59 (GND), U4.69 (GND), U4.87 (GND), U4.96 (GND), U4.111 (GND), U4.122 (GND), U4.128 (GND), U4.142 (GND), U4.162 (GND), U4.187 (GND), U4.202 (GND), U5.2 (GND), U6.14 (GND), U6.20 (~CS), U6.22 (~OE), U9.5, U9.7 (VSS), U9.9, U9.11, U9.13, U10.14 (GND), U11.14 (GND), U12.14 (GND), U13.14 (GND), U14.10 (GND), U14.17 (I3b), U15.10 (GND), U16.10 (GND), U17.10 (GND), U18.14 (GND), U19.2 (XTAL1), U19.7 (EA), U19.20 (GND), U20.15 (GND), U20.40 (GND), U20.66 (GND), U20.78 (GND), U20.90 (GND), U21.1 (OEa), U21.10 (GND), U21.19 (OEb), U22.4 (VSS), U22.9 (VSS), U22.10 (VSS), U22.12 (VSS), U22.13 (VSS), U22.17 (VSS), U22.18 (VSS), U22.29 (VSS), U22.46 (VSS), U22.47 (VSS), U22.52 (VSS), U22.58 (VSS), U22.65 (VSS), U22.66 (VSS), U23.1 (VSS), U23.10 (VSS), U23.11 (VSS), U23.21 (VSS), U23.23 (VSS), U23.25 (VSS), U23.35 (VSS), U23.44 (VSS), U23.48 (VSS), U23.51 (VSS), U23.55 (VSS), U23.57 (VSS), U23.64 (VSS), U23.65 (VSS), U23.66 (VSS), U23.80 (VSS), U23.83 (VSS), U23.90 (VSS), U23.91 (VSS), U23.92 (VSS), U23.105 (VSS), U23.111 (VSS), U23.114 (VSS), U23.122 (VSS), U23.132 (VSS)
HLDA: U1.5, U2.M14 (HLDA), U4.9 (HLDA), U20.24 (HLDA), U23.8 (HLDA)
HOLD: U2.D14 (HOLD), U4.19 (HOLD), U20.26 (HOLD), U23.28 (HOLD)
INTR: U2.B7 (INTR), U4.21 (INTR), U23.53 (INTR)
IOCK: ISA1.32 (IO), ISA2.32 (IO), ISA3.32 (IO), ISA4.32 (IO), ISA5.32 (IO), ISA6.32 (IO), R31.1, U20.64 (~I/OCHCK)
IOCS: ISA1.64 (~IOCS16), ISA3.64 (~IOCS16), ISA4.64 (~IOCS16), ISA5.64 (~IOCS16), ISA6.64 (~IOCS16), RP11.4 (R3), U4.134 (~IOCS16)
IOR: ISA1.14 (~IOR), ISA2.14 (~IOR), ISA3.14 (~IOR), ISA4.14 (~IOR), ISA5.14 (~IOR), ISA6.14 (~IOR), RP12.5 (R4), U4.132 (~IOR), U19.8 (~RD)
IORDY: ISA1.41 (IO_READY), ISA2.41 (IO_READY), ISA3.41 (IO_READY), ISA4.41 (IO_READY), ISA5.41 (IO_READY), ISA6.41 (IO_READY), R32.1, U4.125 (IOCHRDY)
IOW: ISA1.13 (~IOW), ISA2.13 (~IOW), ISA3.13 (~IOW), ISA4.13 (~IOW), ISA5.13 (~IOW), ISA6.13 (~IOW), RP12.4 (R3), U4.131 (~IOW), U19.10 (~WR)
IRQ2: CR5.2 (A), ISA1.4 (IRQ2), ISA2.4 (IRQ2), ISA3.4 (IRQ2), ISA4.4 (IRQ2), ISA5.4 (IRQ2), ISA6.4 (IRQ2), RP9.2 (R1), U20.67 (IRQ2)
IRQ3: ISA1.25 (IRQ3), ISA2.25 (IRQ3), ISA3.25 (IRQ3), ISA4.25 (IRQ3), ISA5.25 (IRQ3), ISA6.25 (IRQ3), RP9.8 (R7), U20.81 (IRQ3)
IRQ4: ISA1.24 (IRQ4), ISA2.24 (IRQ4), ISA3.24 (IRQ4), ISA4.24 (IRQ4), ISA5.24 (IRQ4), ISA6.24 (IRQ4), RP9.7 (R6), U20.77 (IRQ4)
IRQ5: ISA1.23 (IRQ5), ISA2.23 (IRQ5), ISA3.23 (IRQ5), ISA4.23 (IRQ5), ISA5.23 (IRQ5), ISA6.23 (IRQ5), RP9.6 (R5), U20.76 (IRQ5)
IRQ6: ISA1.22 (IRQ6), ISA2.22 (IRQ6), ISA3.22 (IRQ6), ISA4.22 (IRQ6), ISA5.22 (IRQ6), ISA6.22 (IRQ6), RP9.5 (R4), U20.75 (IRQ6)
IRQ7: ISA1.21 (IRQ7), ISA2.21 (IRQ7), ISA3.21 (IRQ7), ISA4.21 (IRQ7), ISA5.21 (IRQ7), ISA6.21 (IRQ7), RP9.4 (R3), U20.74 (IRQ7)
IRQ10: ISA1.65 (IRQ10), ISA3.65 (IRQ10), ISA4.65 (IRQ10), ISA5.65 (IRQ10), ISA6.65 (IRQ10), RP10.3 (R2), U20.82 (IRQ10)
IRQ11: ISA1.66 (IRQ11), ISA3.66 (IRQ11), ISA4.66 (IRQ11), ISA5.66 (IRQ11), ISA6.66 (IRQ11), RP10.4 (R3), U20.83 (IRQ11)
IRQ12: ISA1.67 (IRQ12), ISA3.67 (IRQ12), ISA4.67 (IRQ12), ISA5.67 (IRQ12), ISA6.67 (IRQ12), RP10.5 (R4), U20.84 (IRQ12)
IRQ14: C21.2, ISA1.69 (IRQ14), ISA3.69 (IRQ14), ISA4.69 (IRQ14), ISA5.69 (IRQ14), ISA6.69 (IRQ14), RP10.7 (R6), U20.86 (IRQ14)
IRQ15: ISA1.68 (IRQ15), ISA3.68 (IRQ15), ISA4.68 (IRQ15), ISA5.68 (IRQ15), ISA6.68 (IRQ15), RP10.6 (R5), U20.85 (IRQ15)
KBCI: C5.1, L2.2, R11.2, U19.1 (KBCI), U20.62 (KBCT0)
KBCLK: R8.2, U4.167 (KBCLK)
KBCO: U19.37 (KBCO), U20.59 (KBCP26)
KBCP13: U19.30 (P13), U20.38 (KBCP13)
KBCP21: RP10.9 (R8), U19.22 (~GA20), U20.58 (KBCP21)
KBCP24: RP10.8 (R7), U19.21 (~RC), U20.57 (KBCP24)
KBCRST: U19.4 (~RESET), U20.53 (KBCRST)
KBDI: C4.1, L3.2, R10.2, U19.39 (KBDI/MSCI), U20.61 (KBCT1)
KBDO: U19.38 (KBDO), U20.60 (KBCP27)
KBIRQ1: U19.35 (IRQ1), U20.56 (KBCIRQ)
KBLOCK: J1.4, U19.34 (~KBD_INH)
KEN: U4.208 (~READYO/~KEN), U22.49 (KEN)
LOCK: U3.K1 (PEREQ), U4.205 (FPEREQ/~LOCK), U22.48 (PEREQ)
MASTER: ISA1.79 (MASTER), ISA3.79 (MASTER), ISA4.79 (MASTER), ISA5.79 (MASTER), ISA6.79 (MASTER), RP11.6 (R5), U4.137 (~MASTER), U15.1 (A->B), U16.1 (A->B), U17.1 (A->B), U20.95 (~MASTER)
MEMCS: ISA1.63 (~MEMCS16), ISA3.63 (~MEMCS16), ISA4.63 (~MEMCS16), ISA5.63 (~MEMCS16), ISA6.63 (~MEMCS16), RP11.5 (R4), U4.133 (~MEMCS16)
MEMR: ISA1.89 (~MEMR), ISA3.89 (~MEMR), ISA4.89 (~MEMR), ISA5.89 (~MEMR), ISA6.89 (~MEMR), RP12.7 (R6), U4.127 (~MEMR), U18.22 (~OE), U20.87 (~MEMR16)
MEMW: ISA1.90 (~MEMW), ISA3.90 (~MEMW), ISA4.90 (~MEMW), ISA5.90 (~MEMW), ISA6.90 (~MEMW), RP12.8 (R7), U1.1, U1.2, U4.126 (~MEMW), U20.88 (~MEMR16)
M/IO: U2.A12 (M/~IO), U3.L6 (~NPS1), U4.11 (M/~IO), U22.31 (~NPS1), U23.40 (M/~IO)
NA: RP1.8 (R7), U2.D13 (~NA), U23.30 (~NA)
NCLK: R24.2, U3.K10 (CPUCLK), U22.45 (CPUCLK)
NMI: U2.B8 (NMI), U4.22 (NMI), U23.52 (NMI)
unnamed: C1.1, R1.2
unnamed: C2.1, R4.2, U9.1, Y1.2
unnamed: C3.2, R4.1, R5.1, Y1.1
unnamed: CR2.2 (A), J6.1
unnamed: CR2.1 (K), CR3.2 (A)
unnamed: CR3.1 (K), J6.3, R22.1
unnamed: F1.2, L1.1
unnamed: J1.1, R9.1
unnamed: J3.2, R15.2
unnamed: J5.1, R18.1
unnamed: J8.1 (CLK), L2.1
unnamed: J8.3 (DATA), L3.1
unnamed: C10.2, J8.4 (VCC), L1.2
unnamed: J10.1, R33.1
unnamed: JP1.2, U5.5 (FS1)
unnamed: JP2.2, U5.1 (FS0)
unnamed: JP6.1, RP10.2 (R1)
unnamed: JP6.3, R14.1
unnamed: JP8.1, R25.1, U21.17 (I3b)
unnamed: JP8.2, R24.1
unnamed: Q1.2 (B), R20.1, R21.2
unnamed: Q1.3 (C), Q2.2 (B)
unnamed: Q3.2 (B), R34.2
unnamed: C24.2, Q3.3 (C), R33.2
unnamed: R5.2, U9.2, U9.3
unnamed: RN1.1 (R1.1), U4.99 (~RAS0)
unnamed: RN1.3 (R2.1), U4.98 (~CAS0)
unnamed: RN1.5 (R3.1), U4.97 (~RAS1)
unnamed: RN1.7 (R4.1), U4.95 (~CAS1)
unnamed: RN3.3 (R2.1), U4.66 (~CSEL0)
unnamed: RN3.5 (R3.1), U4.65 (~CSEL1)
unnamed: RN3.7 (R4.1), U4.64 (~CSEL2)
unnamed: RN4.1 (R1.1), U4.93 (~CAS2)
unnamed: RN4.3 (R2.1), U4.91 (~CAS3)
unnamed: RN4.5 (R3.1), U4.90 (~MWE)
unnamed: RN4.7 (R4.1), U4.92 (~RAS3)
unnamed: RN5.3 (R2.1), U4.101 (MA9)
unnamed: RN5.5 (R3.1), U4.100 (MA10)
unnamed: RN7.1 (R1.1), U4.112 (MA0)
unnamed: RN7.3 (R2.1), U4.110 (MA1)
unnamed: RP4.2 (R1), U4.73 (ALT)
unnamed: U1.3, U1.4
unnamed: R3.1, U4.63 (~CSEL3)
unnamed: R2.1, U4.172 (CLKIN)
unnamed: R8.1, U19.3 (XTAL2)
unnamed: R28.1, U21.2 (I0a), U21.4 (I1a), U21.6 (I2a)
unnamed: R26.1, U21.8 (I3a)
unnamed: R27.2, U21.18 (O0a)
unnamed: R23.1, U21.7 (O1b)
unnamed: R30.2, U21.14 (O2a)
unnamed: R29.2, U21.12 (O3a)
unnamed: BC1.2, L5.2, U21.20 (VCC)
OSC: C20.1, ISA1.30 (OSC), ISA2.30 (OSC), ISA3.30 (OSC), ISA4.30 (OSC), ISA5.30 (OSC), ISA6.30 (OSC), R23.2
PCD: RP1.4 (R3), U3.K2 (~BUSY), U4.206 (~FBUSY/PCD), U22.23 (~BUSY)
PEREQ: U2.C8 (PEREQ), U4.207 (PEREQ/~BRDY), U23.50 (PEREQ)
PWRGD: J7.12 (PWRGD), R16.2, U20.52 (PWRGD)
READY: RP3.4 (R3), U2.G13 (~READY), U3.K8 (~READY), U4.17 (~READY), U22.37 (~READY), U23.26 (~READY)
REFSH: U15.19 (CE), U16.19 (CE), U17.19 (CE), U20.96 (REFRESH)
RESET: ISA1.2 (RESET), ISA2.2 (RESET), ISA3.2 (RESET), ISA4.2 (RESET), ISA5.2 (RESET), ISA6.2 (RESET), U21.5 (O2b)
RFSH: ISA1.19 (~REFRESH), ISA2.19 (~DACK0), ISA3.19 (~REFRESH), ISA4.19 (~REFRESH), ISA5.19 (~REFRESH), ISA6.19 (~REFRESH), RP11.2 (R1), U4.136 (~REFRESH), U14.1 (OEa), U14.19 (OEb), U20.73 (~REFRESH)
ROMCS: U4.168 (~ROMCS), U18.20 (~CE), U19.6 (~CS)
RST: C13.1, CR1.2 (A), R15.1, R19.2, U20.30 (RST)
RSTCPU: U2.C9 (RESET), U4.20 (RSTCPU), U23.45 (RESET)
SBHE: ISA1.81 (SBHE), ISA3.81 (SBHE), ISA4.81 (SBHE), ISA5.81 (SBHE), ISA6.81 (SBHE), RP12.6 (R5), U15.12 (B6)
SEL0: R12.2, U4.119 (SEL0), U20.2 (SEL0)
SEL2: RP9.9 (R8), U4.117 (SEL2), U20.4 (SEL2)
SMEMR: ISA1.11 (~SMEMW), ISA2.11 (~SMEMW), ISA3.11 (~SMEMW), ISA4.11 (~SMEMW), ISA5.11 (~SMEMW), ISA6.11 (~SMEMW), RP12.2 (R1), U20.69 (~MEMR)
SMEMW: ISA1.12 (~SMEMR), ISA2.12 (~SMEMR), ISA3.12 (~SMEMR), ISA4.12 (~SMEMR), ISA5.12 (~SMEMR), ISA6.12 (~SMEMR), RP12.3 (R2), U20.70 (~MEMW)
SPKR: R34.1, U4.138 (SPK)
SYSRST: U3.L10 (RESET), U4.140 (SYSRST), U20.31 (SYSRST), U21.15 (I2b), U22.39 (RESET)
TBLED: J5.2, U20.42 (TURBOLED)
TC: ISA1.27 (TC), ISA2.27 (TC), ISA3.27 (TC), ISA4.27 (TC), ISA5.27 (TC), ISA6.27 (TC), U4.124 (TC)
TURBO: C14.1, J4.2, R17.2, U4.5 (TURBO), U20.39 (TURBO)
VCC: BC2.1, BC3.1, BC4.1, BC5.1, BC6.1, BC9.1, BC10.1, BC11.1, BC12.1, BC13.1, BC14.1, BC15.1, BC16.1, BC18.1, BC19.1, BC20.1, BC21.1, BC22.1, BC23.1, BC24.1, BC25.1, BC26.1, C9.1, C25.1, C26.1, C27.1, C28.1, CR1.1 (K), F1.1, ISA1.3 (+5V), ISA1.29 (VCC), ISA1.78 (+5V), ISA2.3 (VCC), ISA2.29 (VCC), ISA3.3 (+5V), ISA3.29 (VCC), ISA3.78 (+5V), ISA4.3 (+5V), ISA4.29 (VCC), ISA4.78 (+5V), ISA5.3 (+5V), ISA5.29 (VCC), ISA5.78 (+5V), ISA6.3 (+5V), ISA6.29 (VCC), ISA6.78 (+5V), J7.1 (+5V), J7.2 (+5V), J7.3 (+5V), J7.11 (+5V), J10.4, JP1.1, JP2.1, L5.1, Q2.1 (E), R9.2, R12.1, R16.1, R17.1, R18.2, R19.1, R21.1, R31.2, R32.2, RP1.1 (common), RP3.1 (common), RP4.1 (common), RP5.1 (common), RP6.1 (common), RP7.1 (common), RP9.1 (common), RP10.1 (common), RP11.1 (common), RP12.1 (common), RP13.1 (common), RP14.1 (common), SIM1.1 (VCC), SIM1.30 (VCC), SIM2.1 (VCC), SIM2.30 (VCC), SIM3.1 (VCC), SIM3.30 (VCC), SIM4.1 (VCC), SIM4.30 (VCC), SIM5.1 (VCC), SIM5.30 (VCC), SIM6.1 (VCC), SIM6.30 (VCC), SIM7.1 (VCC), SIM7.30 (VCC), SIM8.1 (VCC), SIM8.30 (VCC), U1.14 (VCC), U2.A1 (VCC), U2.A5 (VCC), U2.A7 (VCC), U2.A10 (VCC), U2.A14 (VCC), U2.C5 (VCC), U2.C12 (VCC), U2.D12 (VCC), U2.G2 (VCC), U2.G3 (VCC), U2.G12 (VCC), U2.G14 (VCC), U2.L12 (VCC), U2.M3 (VCC), U2.M7 (VCC), U2.M13 (VCC), U2.N4 (VCC), U2.N7 (VCC), U2.P2 (VCC), U2.P8 (VCC), U3.A6 (VCC), U3.A9 (VCC), U3.B4 (VCC), U3.E1 (VCC), U3.F1 (VCC), U3.F10 (VCC), U3.J2 (VCC), U3.J11 (CKM), U3.K3 (PULLUP), U3.K5 (VCC), U3.L4 (STEN), U3.L7 (VCC), U3.L9 (PULLUP), U5.7 (VCC), U6.1 (A14), U6.26 (A13), U6.28 (VCC), U10.28 (VCC), U11.28 (VCC), U12.28 (VCC), U13.28 (VCC), U14.20 (VCC), U15.20 (VCC), U16.20 (VCC), U17.20 (VCC), U18.28 (VCC), U19.5 (~SS), U19.25 (PROG), U19.26 (VCC), U19.40 (VCC), U20.41 (VCC), U20.91 (VCC), U22.5 (VCC), U22.6 (VCC), U22.11 (VCC), U22.19 (VCC), U22.26 (VCC), U22.30 (VCC), U22.33 (VCC), U22.34 (VCC), U22.38 (VCC), U22.54 (VCC), U22.64 (VCC), U22.70 (VCC), U22.71 (VCC), U22.75 (VCC), U22.76 (VCC), U23.2 (VCC), U23.16 (VCC), U23.22 (VCC), U23.34 (VCC), U23.49 (VCC), U23.54 (~FLT), U23.56 (VCC), U23.58 (VCC), U23.73 (VCC), U23.85 (VCC), U23.99 (VCC), U23.106 (VCC), U23.110 (VCC), U23.117 (VCC), U23.123 (VCC), U23.127 (VCC)
VDD: BC7.2, BC8.2, C15.1, C16.2, Q2.3 (C), R22.2, U4.45 (VCC), U4.53 (VCC), U4.78 (VCC), U4.102 (VCC), U4.115 (VCC), U4.149 (VCC), U4.173 (VCC), U4.195 (VCC), U9.14 (VDD)
WRKRDY: RP3.5 (R4), U4.203 (~WRKRDY)
W/R: U2.B10 (~W/R), U3.K4 (~W/R), U4.10 (~W/R), U22.28 (~W/R), U23.43 (~W/R)
X1CLK: U4.139 (OSC), U5.3 (X1), U20.32 (OSC), U21.13 (I1b)
XD0: ISA1.40 (DB0), ISA2.40 (DB0), ISA3.40 (DB0), ISA4.40 (DB0), ISA5.40 (DB0), ISA6.40 (DB0), RP14.9 (R8), U4.166 (SD0), U18.11 (D0), U19.12 (DB0)
XD1: ISA1.39 (DB1), ISA2.39 (DB1), ISA3.39 (DB1), ISA4.39 (DB1), ISA5.39 (DB1), ISA6.39 (DB1), RP14.8 (R7), U4.165 (SD1), U18.12 (D1), U19.13 (DB1)
XD2: ISA1.38 (DB2), ISA2.38 (DB2), ISA3.38 (DB2), ISA4.38 (DB2), ISA5.38 (DB2), ISA6.38 (DB2), RP14.7 (R6), U4.164 (SD2), U18.13 (D2), U19.14 (DB2)
XD3: ISA1.37 (DB3), ISA2.37 (DB3), ISA3.37 (DB3), ISA4.37 (DB3), ISA5.37 (DB3), ISA6.37 (DB3), RP14.6 (R5), U4.163 (SD3), U18.15 (D3), U19.15 (DB3)
XD4: ISA1.36 (DB4), ISA2.36 (DB4), ISA3.36 (DB4), ISA4.36 (DB4), ISA5.36 (DB4), ISA6.36 (DB4), RP14.5 (R4), U4.161 (SD4), U18.16 (D4), U19.16 (DB4)
XD5: ISA1.35 (DB5), ISA2.35 (DB5), ISA3.35 (DB5), ISA4.35 (DB5), ISA5.35 (DB5), ISA6.35 (DB5), RP14.4 (R3), U4.160 (SD5), U18.17 (D5), U19.17 (DB5)
XD6: ISA1.34 (DB6), ISA2.34 (DB6), ISA3.34 (DB6), ISA4.34 (DB6), ISA5.34 (DB6), ISA6.34 (DB6), RP14.3 (R2), U4.159 (SD6), U18.18 (D6), U19.18 (DB6)
XD7: ISA1.33 (DB7), ISA2.33 (DB7), ISA3.33 (DB7), ISA4.33 (DB7), ISA5.33 (DB7), ISA6.33 (DB7), RP14.2 (R1), U4.158 (SD7), U18.19 (D7), U19.19 (DB7)
XD8: ISA1.91 (D8), ISA3.91 (D8), ISA4.91 (D8), ISA5.91 (D8), ISA6.91 (D8), RP13.2 (R1), U4.157 (SD8)
XD9: ISA1.92 (D9), ISA3.92 (D9), ISA4.92 (D9), ISA5.92 (D9), ISA6.92 (D9), RP13.3 (R2), U4.156 (SD9)
XD10: ISA1.93 (D10), ISA3.93 (D10), ISA4.93 (D10), ISA5.93 (D10), ISA6.93 (D10), RP13.4 (R3), U4.155 (SD10)
XD11: ISA1.94 (D11), ISA3.94 (D11), ISA4.94 (D11), ISA5.94 (D11), ISA6.94 (D11), RP13.5 (R4), U4.154 (SD11)
XD12: ISA1.95 (D12), ISA3.95 (D12), ISA4.95 (D12), ISA5.95 (D12), ISA6.95 (D12), RP13.6 (R5), U4.153 (SD12)
XD13: ISA1.96 (D13), ISA3.96 (D13), ISA4.96 (D13), ISA5.96 (D13), ISA6.96 (D13), RP13.7 (R6), U4.152 (SD13)
XD14: ISA1.97 (D14), ISA3.97 (D14), ISA4.97 (D14), ISA5.97 (D14), ISA6.97 (D14), RP13.8 (R7), U4.151 (SD14)
XD15: ISA1.98 (D15), ISA3.98 (D15), ISA4.98 (D15), ISA5.98 (D15), ISA6.98 (D15), RP13.9 (R8), U4.150 (SD15)
ZWS: ISA1.8 (UNUSED), ISA2.8 (UNUSED), ISA3.8 (UNUSED), ISA4.8 (UNUSED), ISA5.8 (UNUSED), ISA6.8 (UNUSED), RP11.3 (R2), U4.135 (~ZWS)
pullup?: RP8.9 (R8), U20.97 (pullup?)
pullup??: RP9.3 (R2), U20.98 (pullup?)
